shirokuma89dev/BLDRV_Gen2/BLDRV_Gen2.pdf

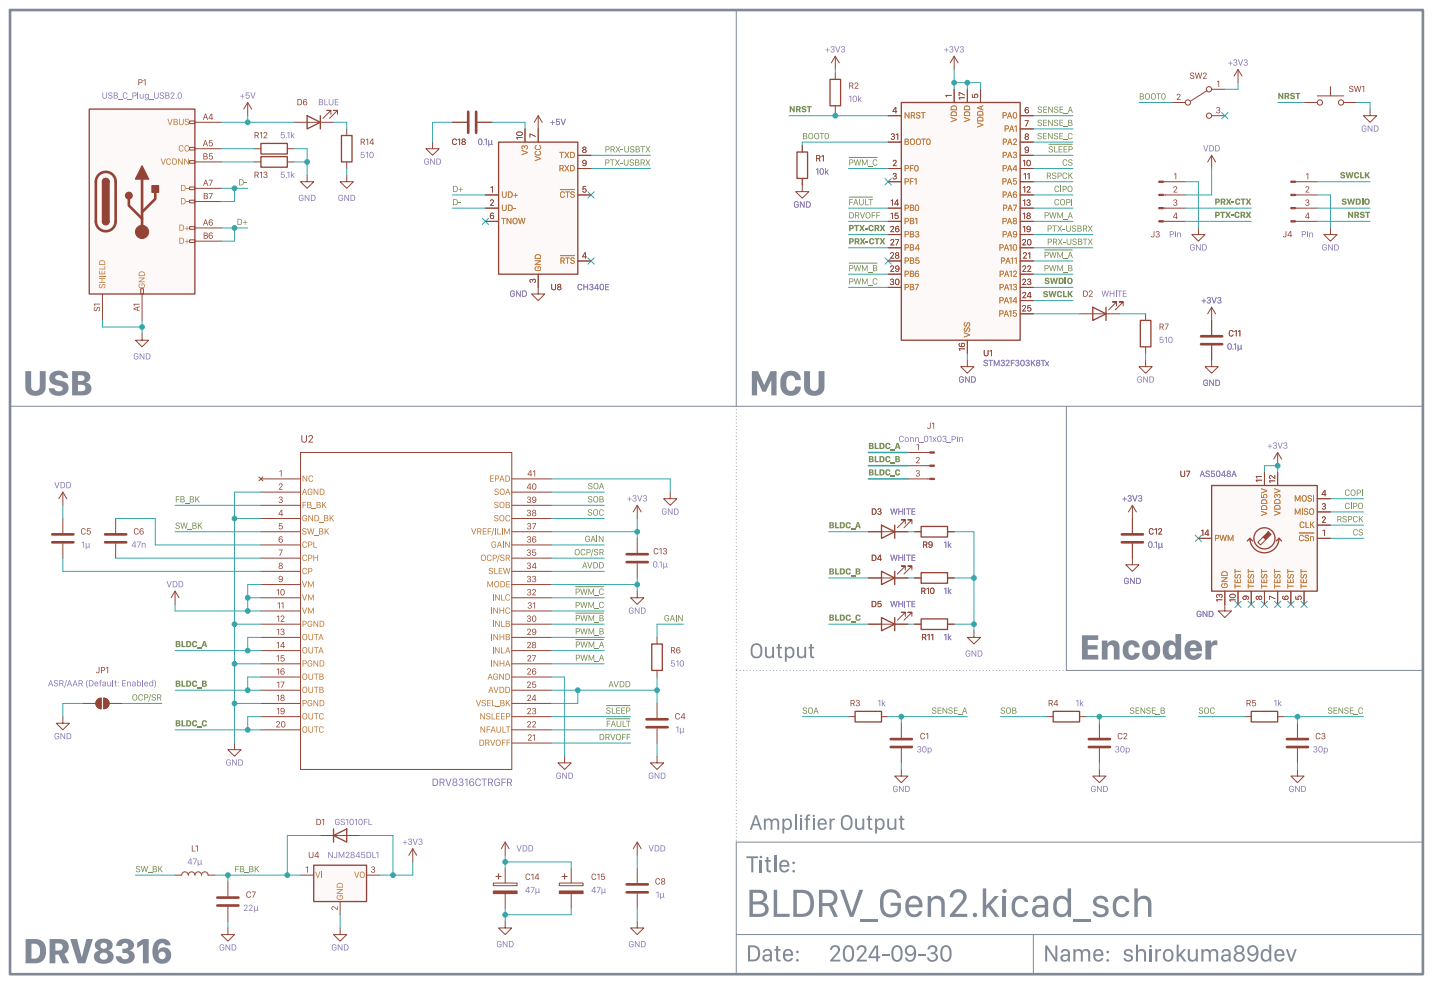
[picture p1: page 1]
