shirokuma89dev/BLDRV_Gen2/BLDRV_Gen2.kicad_pcb

## KiCad design BLDRV_Gen2.kicad_pcb (2024-09-28)

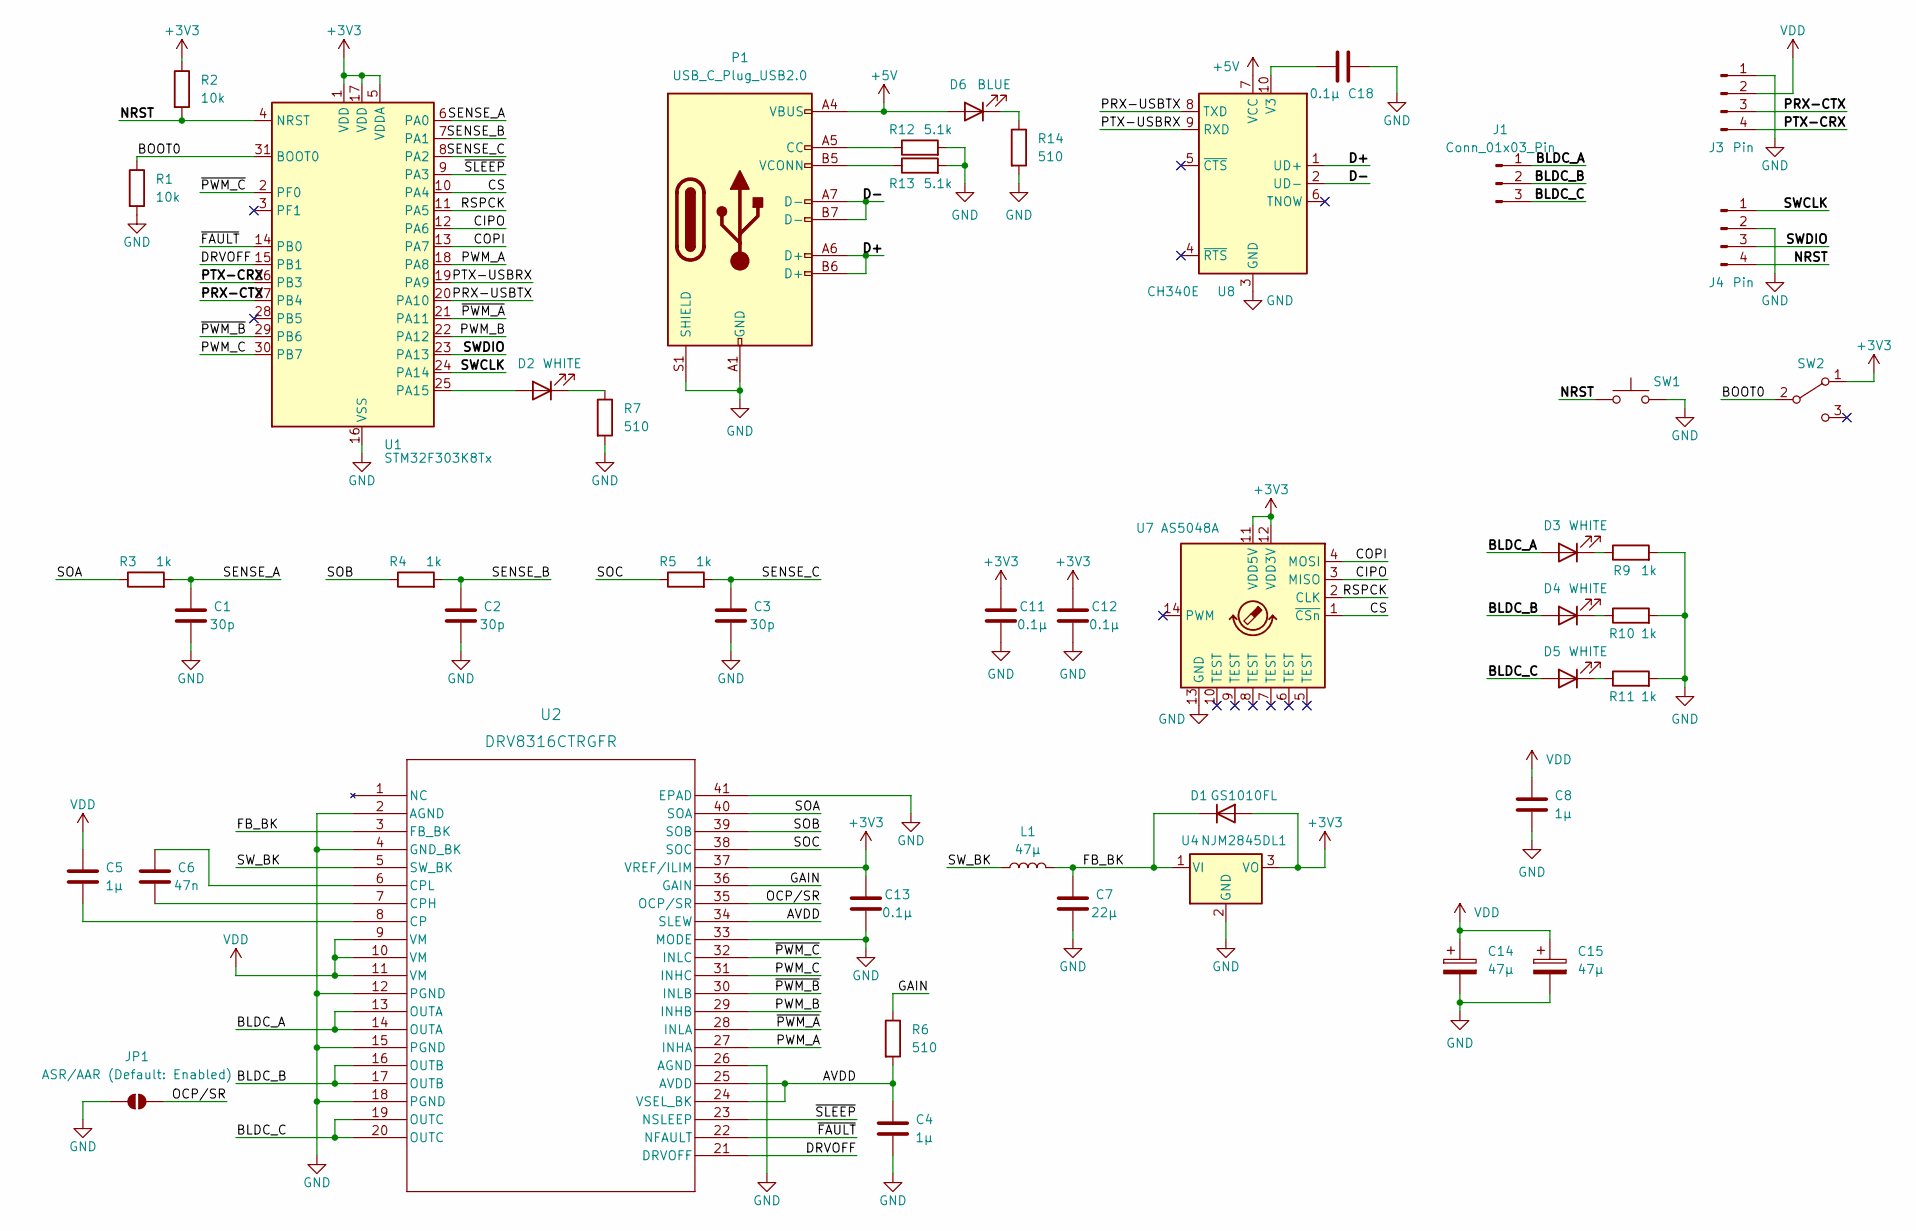
[picture p2: schematic BLDRV_Gen2.kicad_sch]

Parts:
C1, C2, C3: 30p; C_0603_1608Metric
C4, C5: 1μ; C_0603_1608Metric
C6: 47n; C_0603_1608Metric
C7: 22µ; C_0603_1608Metric
C8: 1µ; C_0603_1608Metric
C11, C12, C13, C18: 0.1µ; C_0603_1608Metric
C14, C15: 47μ; CP_Elec_5x5.3
D1: GS1010FL; D_SOD-123
D2, D3, D4, D5: WHITE; LED_0603_1608Metric
D6: BLUE; LED_0603_1608Metric
J1: Conn_01x03_Pin; Molex_SPOX_5268-03A_1x03_P2.50mm_Horizontal
J3: Pin; Molex_SPOX_5268-04A_1x04_P2.50mm_Horizontal
J4: Pin; PinHeader_1x04_P1.00mm_Vertical
JP1: ASR/AAR (Default: Enabled); SolderJumper-2_P1.3mm_Open_TrianglePad1.0x1.5mm
L1: 47μ; L_6.3x6.3_H3
P1: USB_C_Plug_USB2.0; USB_C_Receptacle_HCTL_HC-TYPE-C-16P-01A
R1, R2: 10k; R_0402_1005Metric
R3, R4, R5, R9, R10, R11: 1k; R_0402_1005Metric
R6, R7, R14: 510; R_0402_1005Metric
R12, R13: 5.1k; R_0402_1005Metric
SW1: SW_Push; SW_PUSH_6mm
SW2: SW_SPDT; SW_Slide_SPDT_Angled_CK_OS102011MA1Q
U1: STM32F303K8Tx; LQFP-32_7x7mm_P0.8mm
U2: DRV8316CTRGFR; VQFN40_RGF_TEX
U4: NJM2845DL1; TO-252-2
U7: AS5048A; TSSOP-14_4.4x5mm_P0.65mm
U8: CH340E; MSOP-10_3x3mm_P0.5mm

Connections:
+3V3: C11.2, C12.2, C13.2, D1.2 (A), R2.1, SW2.1 (A), U1.1 (VDD), U1.5 (VDDA), U1.17 (VDD), U2.37 (VREF/ILIM), U4.3 (VO), U7.11 (VDD5V), U7.12 (VDD3V)
+5V: D6.2 (A), P1.A4 (VBUS), P1.A9 (VBUS), P1.B4 (VBUS), P1.B9 (VBUS), U8.7 (VCC)
/AVDD: C4.2, R6.2, U2.24 (VSEL_BK), U2.25 (AVDD), U2.34 (SLEW)
/BLDC_A: D3.2 (A), J1.1, U2.13 (OUTA), U2.14 (OUTA)
/BLDC_B: D4.2 (A), J1.2, U2.16 (OUTB), U2.17 (OUTB)
/BLDC_C: D5.2 (A), J1.3, U2.19 (OUTC), U2.20 (OUTC)
/BOOT0: R1.1, SW2.2 (B), U1.31 (BOOT0)
/CIPO: U1.12 (PA6), U7.3 (MISO)
/COPI: U1.13 (PA7), U7.4 (MOSI)
/CS: U1.10 (PA4), U7.1 (~CSn)
/D+: P1.A6 (D+), P1.B6 (D+), U8.1 (UD+)
/D-: P1.A7 (D-), P1.B7 (D-), U8.2 (UD-)
/DRVOFF: U1.15 (PB1), U2.21 (DRVOFF)
/FB_BK: C7.2, D1.1 (K), L1.2, U2.3 (FB_BK), U4.1 (VI)
/GAIN: R6.1, U2.36 (GAIN)
/NRST: J4.4, R2.2, SW1.1, U1.4 (NRST)
/OCP/SR: JP1.2 (B), U2.35 (OCP/SR)
/PRX-CTX: J3.3, U1.27 (PB4)
/PRX-USBTX: U1.20 (PA10), U8.8 (TXD)
/PTX-CRX: J3.4, U1.26 (PB3)
/PTX-USBRX: U1.19 (PA9), U8.9 (RXD)
/PWM_A: U1.18 (PA8), U2.27 (INHA)
/PWM_B: U1.22 (PA12), U2.29 (INHB)
/PWM_C: U1.30 (PB7), U2.31 (INHC)
/RSPCK: U1.11 (PA5), U7.2 (CLK)
/SENSE_A: C1.2, R3.2, U1.6 (PA0)
/SENSE_B: C2.2, R4.2, U1.7 (PA1)
/SENSE_C: C3.2, R5.2, U1.8 (PA2)
/SOA: R3.1, U2.40 (SOA)
/SOB: R4.1, U2.39 (SOB)
/SOC: R5.1, U2.38 (SOC)
/SWCLK: J4.1, U1.24 (PA14)
/SWDIO: J4.3, U1.23 (PA13)
/SW_BK: L1.1, U2.5 (SW_BK)
/~FAULT: U1.14 (PB0), U2.22 (NFAULT)
/~PWM_A: U1.21 (PA11), U2.28 (INLA)
/~PWM_B: U1.29 (PB6), U2.30 (INLB)
/~PWM_C: U1.2 (PF0), U2.32 (INLC)
/~SLEEP: U1.9 (PA3), U2.23 (NSLEEP)
GND: C1.1, C2.1, C3.1, C4.1, C7.1, C8.1, C11.1, C12.1, C13.1, C14.2, C15.2, C18.2, J3.1, J4.2, JP1.1 (A), P1.A1 (GND), P1.A12 (GND), P1.B1 (GND), P1.B12 (GND), P1.S1 (SHIELD), R1.2, R7.2, R9.2, R10.2, R11.2, R12.2, R13.2, R14.2, SW1.2, U1.16 (VSS), U1.32 (VSS), U2.2 (AGND), U2.4 (GND_BK), U2.12 (PGND), U2.15 (PGND), U2.18 (PGND), U2.26 (AGND), U2.33 (MODE), U2.41 (EPAD), U4.2 (GND), U7.13 (GND), U8.3 (GND)
unnamed: D2.2 (A), U1.25 (PA15)
unnamed: D2.1 (K), R7.1
unnamed: D3.1 (K), R9.1
unnamed: D4.1 (K), R10.1
unnamed: D5.1 (K), R11.1
unnamed: D6.1 (K), R14.1
unnamed: P1.A5 (CC), R12.1
unnamed: P1.B5 (VCONN), R13.1
unnamed: C5.1, U2.8 (CP)
unnamed: C6.1, U2.7 (CPH)
unnamed: C6.2, U2.6 (CPL)
unnamed: C18.1, U8.10 (V3)
VDD: C5.2, C8.2, C14.1, C15.1, J3.2, U2.9 (VM), U2.10 (VM), U2.11 (VM)

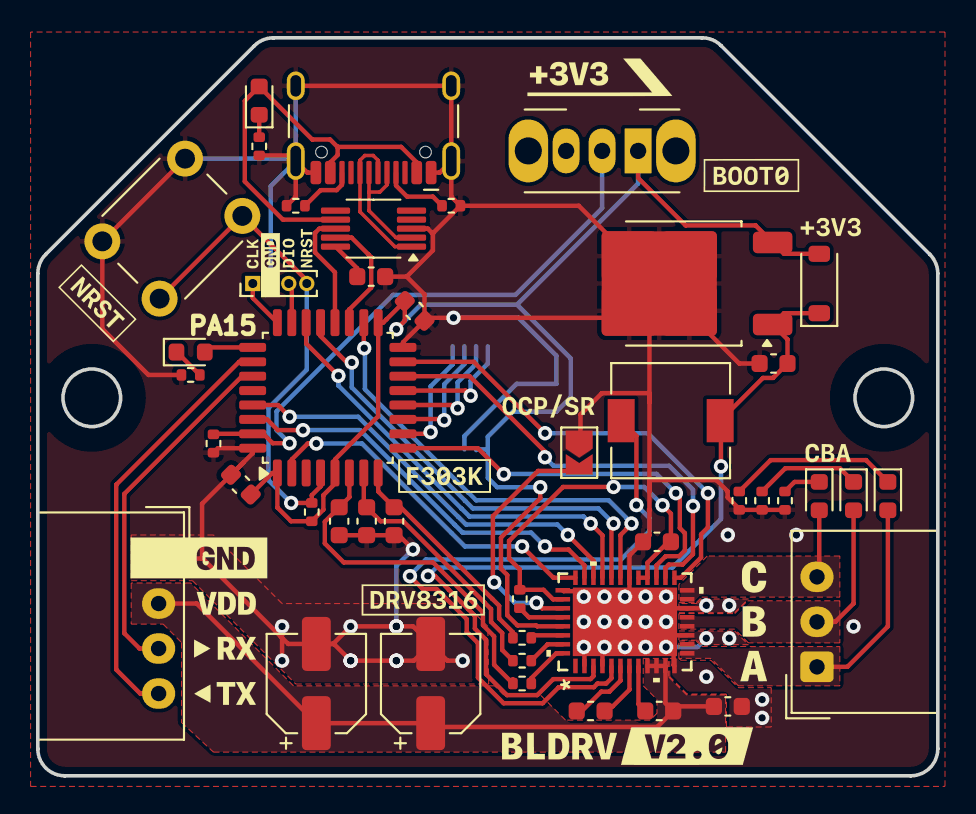
[picture p3: board BLDRV_Gen2.kicad_pcb from above]

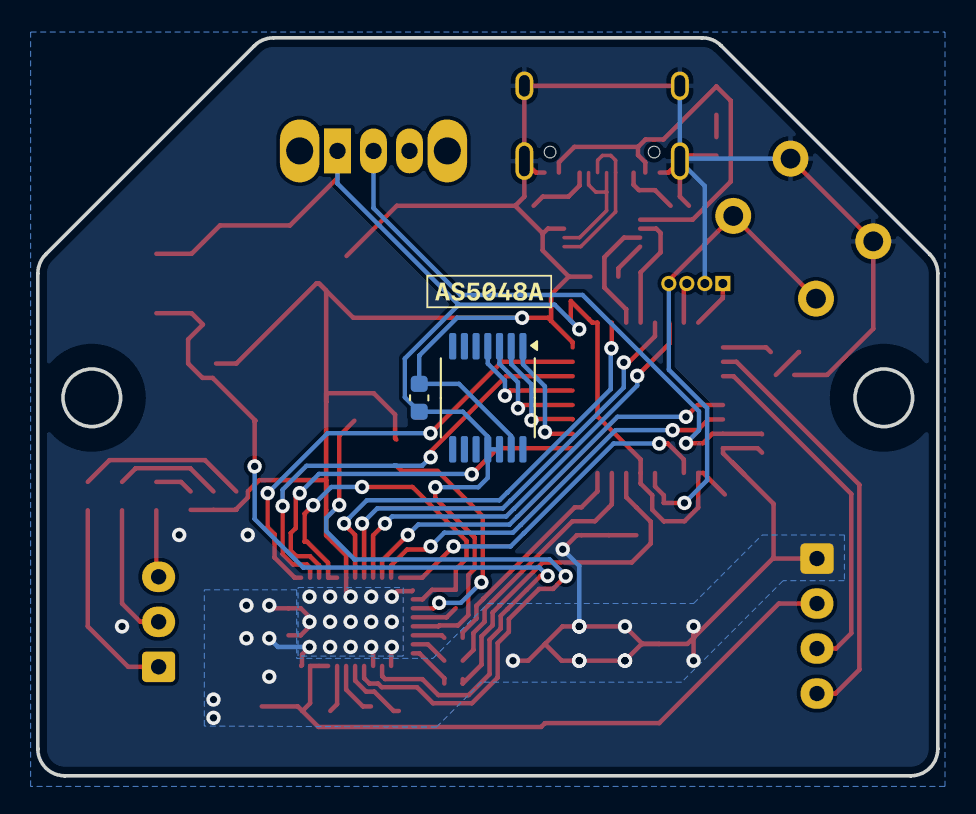
[picture p4: board BLDRV_Gen2.kicad_pcb from below]

Board: 2 copper layers, 50.0 x 41.0 mm, 46 parts (2 on the bottom side), 53 nets.
