shirokuma89dev/BLDRV_Gen2/BLDRV_Gen2_Firmware/BLDRV_Gen2_Firmware.ioc

Mcu.UserName=STM32F303K8Tx
PA0.Signal=ADC1_IN1
PA1.Signal=ADC1_IN2
PA10.Signal=USART1_RX
PA11.GPIO_Label=PWM_A_L
PA11.Signal=TIM1_CH1N
PA12.GPIO_Label=PWM_B_H
PA12.Signal=S_TIM16_CH1
PA13.GPIO_Label=SWDIO
PA13.Signal=SYS_JTMS-SWDIO
PA14.GPIO_Label=SWCLK
PA14.Signal=SYS_JTCK-SWCLK
PA15.Signal=S_TIM2_CH1_ETR
PA2.Signal=ADC1_IN3
PA4.Signal=GPIO_Output
PA5.Signal=SPI1_SCK
PA6.Signal=SPI1_MISO
PA7.Signal=SPI1_MOSI
PA8.GPIO_Label=PWM_A_H
PA8.Signal=S_TIM1_CH1
PA9.Signal=USART1_TX
PB1.GPIO_Label=DRVOFF
PB1.Signal=GPIO_Output
PB3.Signal=USART2_TX
PB4.Signal=USART2_RX
PB6.GPIO_Label=PWM_B_L
PB6.Signal=TIM16_CH1N
PB7.GPIO_Label=PWM_C_H
PB7.Signal=S_TIM3_CH4
