shirokuma89dev/BLDRV_Gen2/BLDRV_Gen2_Firmware/Core/Inc/main.h

#define PWM_C_L_Pin GPIO_PIN_0
#define PWM_C_L_GPIO_Port GPIOF
#define DRVOFF_Pin GPIO_PIN_1
#define DRVOFF_GPIO_Port GPIOB
#define PWM_A_H_Pin GPIO_PIN_8
#define PWM_A_H_GPIO_Port GPIOA
#define PWM_A_L_Pin GPIO_PIN_11
#define PWM_A_L_GPIO_Port GPIOA
#define PWM_B_H_Pin GPIO_PIN_12
#define PWM_B_H_GPIO_Port GPIOA
#define SWDIO_Pin GPIO_PIN_13
#define SWDIO_GPIO_Port GPIOA
#define SWCLK_Pin GPIO_PIN_14
#define SWCLK_GPIO_Port GPIOA
#define PWM_B_L_Pin GPIO_PIN_6
#define PWM_B_L_GPIO_Port GPIOB
#define PWM_C_H_Pin GPIO_PIN_7
#define PWM_C_H_GPIO_Port GPIOB
