shirokuma89dev/BLDRV_Gen2/BLDRV_Gen2_Firmware/Core/Inc/dma_printf.h

//
// Created by naoki on 19/03/09.
//

#ifndef HAL_DMA_PRINTF_DMA_PRINTF_H
#define HAL_DMA_PRINTF_DMA_PRINTF_H
#include "dma_ring.h"
#include "main.h"

struct dma_printf_info {
    struct dma_ring_buf tx_ring;
    int sending;
    UART_HandleTypeDef *huart;
    int previous_send_len;
};

void dma_printf_init(UART_HandleTypeDef *printf_huart);
void dma_printf_putc(uint8_t c);
void dma_printf_send_it(UART_HandleTypeDef *printf_huart);
void dma_printf_puts(const char *s);
#endif  // HAL_DMA_PRINTF_DMA_PRINTF_H
