shirokuma89dev/BLDRV_Gen2/(commit log)

2024-09-28 ✅ 正弦波駆動
2024-09-28 ✨ q軸電圧一定制御
2024-09-28 ⚡️ 角度系を変更
2024-09-28 🐛 キャリブレーションの角度系
2024-09-28 💩 ゴミベクトル制御
2024-09-29 💩 q軸電流のこと誰が好きなん？
2024-09-29 ✅ もうどうでも良くなった
2024-09-29 ♻️ 回路図
    [BLDRV_Gen2.kicad_sch]
2024-10-03 ✅ 動くプログラム
2024-10-03 ⚡️ バッファを2->4byteに変更
