shirokuma89dev/BLDRV_Gen2/(notices)

Notices in the files:
BLDRV_Gen2_Firmware/Core/Inc/main.h:
Copyright (c) 2024 STMicroelectronics.
All rights reserved.
This software is licensed under terms that can be found in the LICENSE file
